restep-eco/EMI-Filter/EMI-Filter_Installed2.jpg

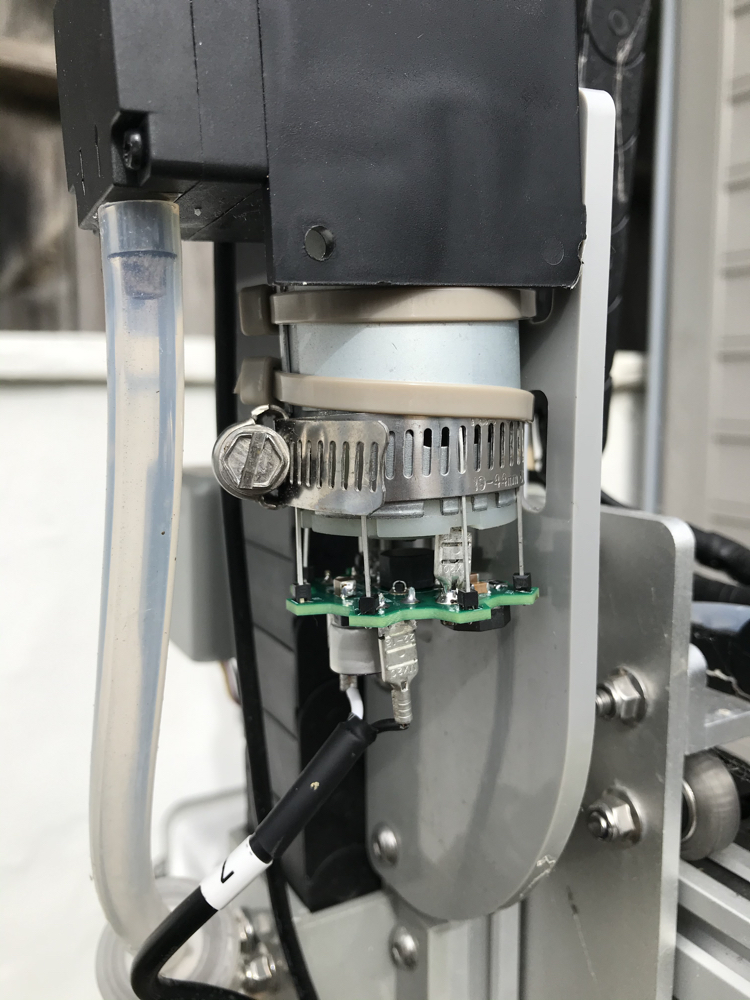
EMI-Filter_Installed2.jpg
