restep-eco/EMI-Filter/EMI-Filter-Installed3.jpg

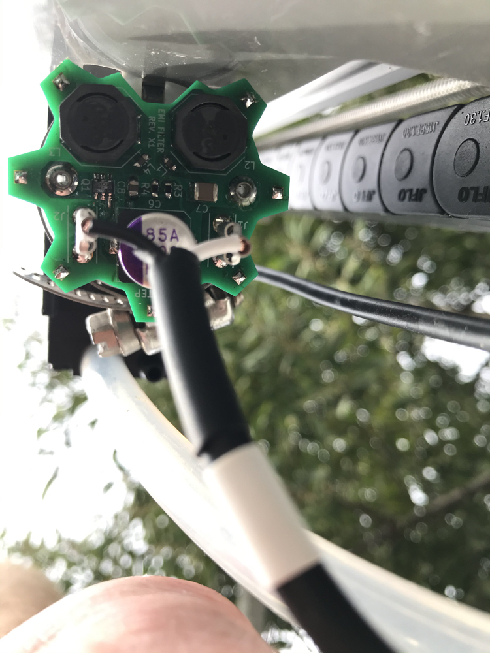
EMI-Filter-Installed3.jpg
