restep-eco/EMI-Filter/README.md

# EMI-Filter
RESTEP EMI FILTER

EMI Filter for the 24V FarmBot vacuum pump

Initial release (Rev.X1) 3/13/21: This revision is a prototype release. It is not fully tested or qualified.

Copyright RESTEP 2021.
This source describes Open Hardware and is licensed under the CERN-OHL-P v2
You may redistribute and modify this documentation and make products
using it under the terms of the CERN-OHL-P v2 (https:/cern.ch/cern-ohl).
This documentation is distributed WITHOUT ANY EXPRESS OR IMPLIED
WARRANTY, INCLUDING OF MERCHANTABILITY, SATISFACTORY QUALITY
AND FITNESS FOR A PARTICULAR PURPOSE. Please see the CERN-OHL-P v2
for applicable conditions.

Source files developed in KiCad 5.0.2.
Custom libraries and footprints are provided in the source files .zip.

All documentation is licensed under the Creative Commons Attribution 4.0 International License.

LTSpice circuit models (*.asc) are licensed under the MIT license.
