restep-eco/EMI-Filter/EMI-Filter-Back.jpg

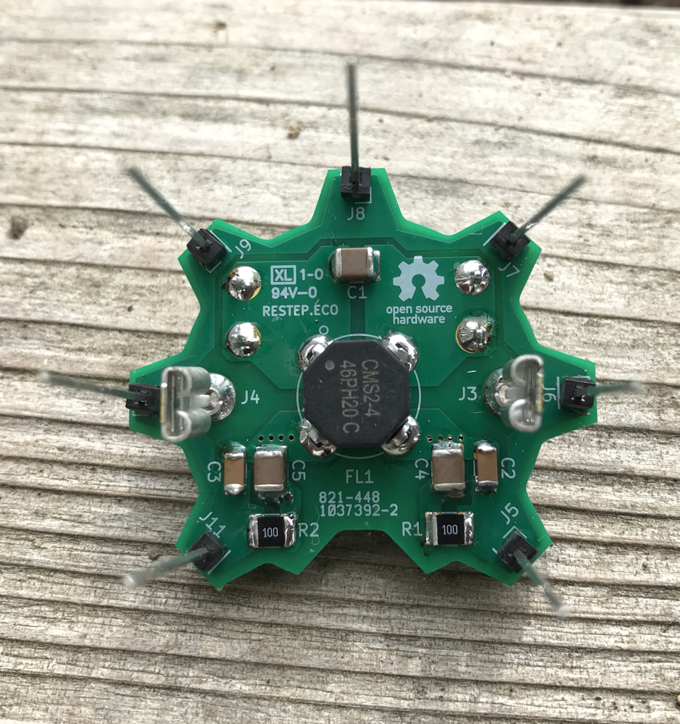
EMI-Filter-Back.jpg
