restep-eco/EMI-Filter/EMI-Filter-Front.jpg

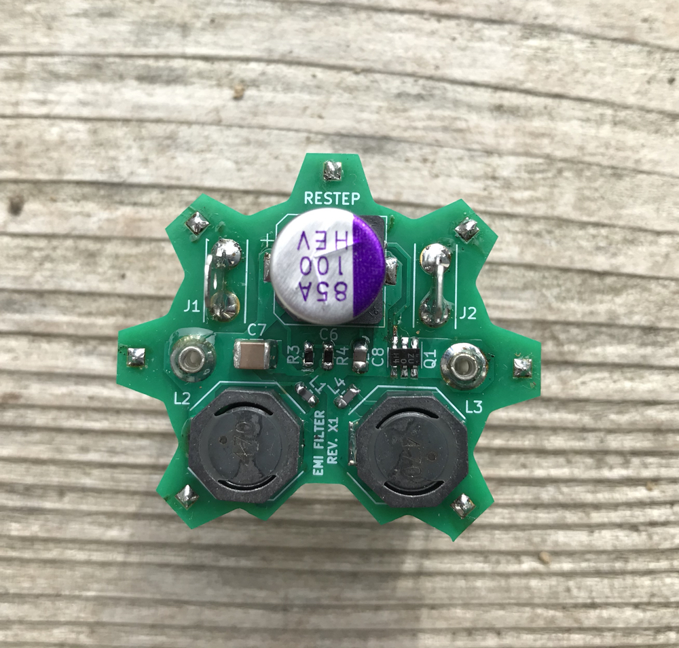
EMI-Filter-Front.jpg
