restep-eco/EMI-Filter/RESTEP EMI FILTER SCHEMATIC.pdf

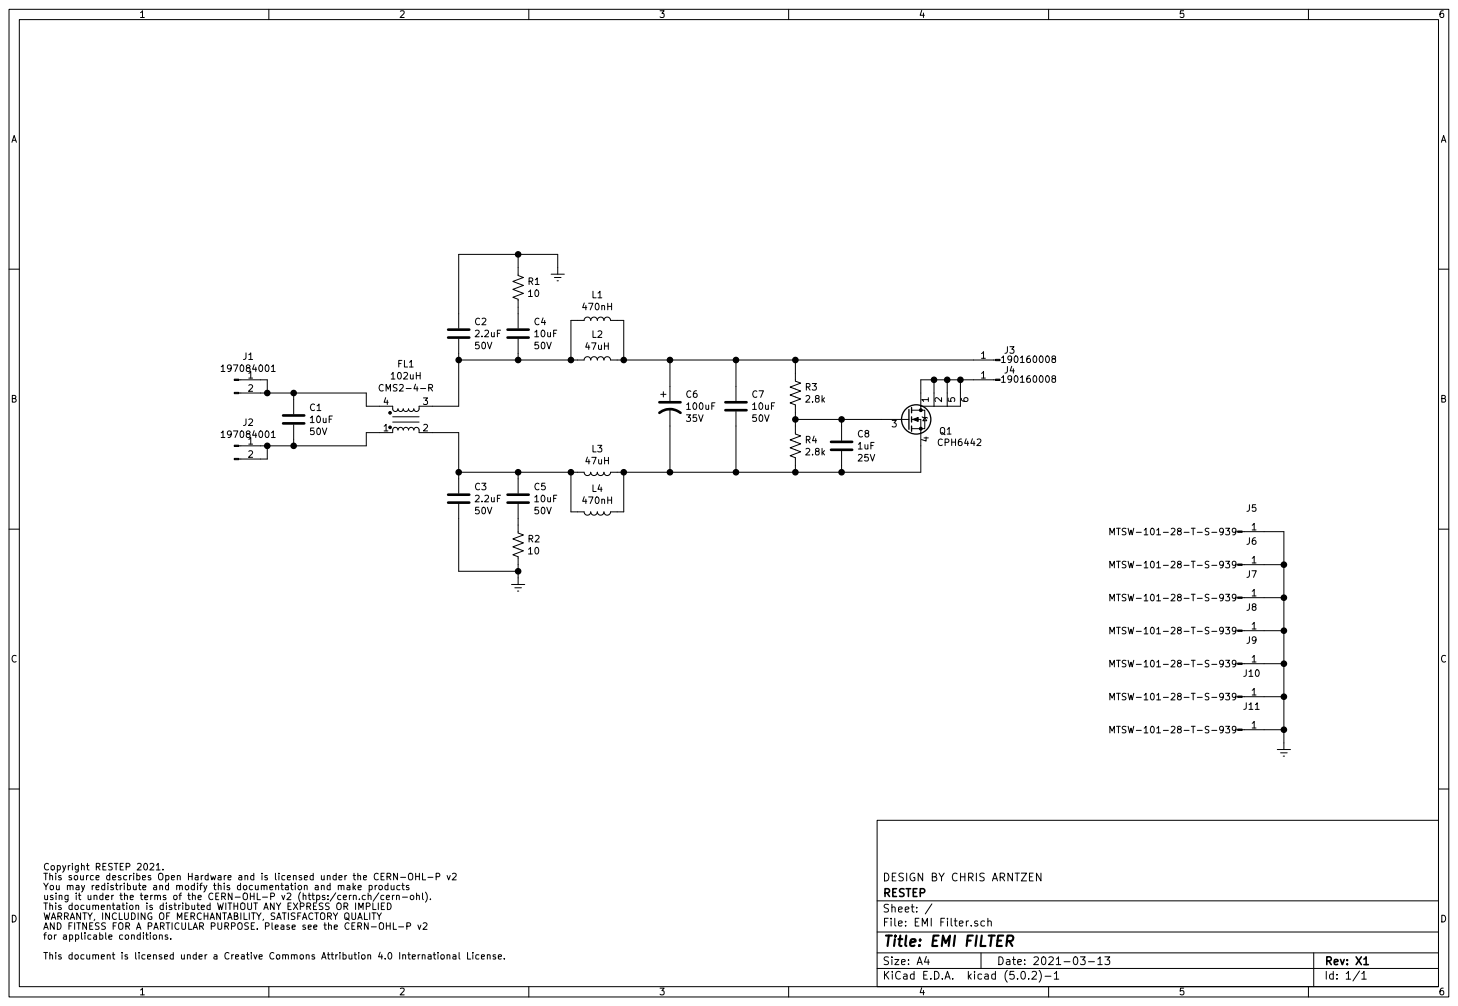
[picture p5: page 1]
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

File: EMI Filter.sch Sheet: / RESTEP DESIGN BY CHRIS ARNTZEN

AND FITNESS FOR A PARTICULAR PURPOSE. Please see the CERN-OHL-P v2
for applicable conditions. This document is licensed under a Creative Commons Attribution 4.0 International License.

Id: 1/1 Title: EMI FILTER
