restep-eco/EMI-Filter/RESTEP EMI FILTER PCB.pdf

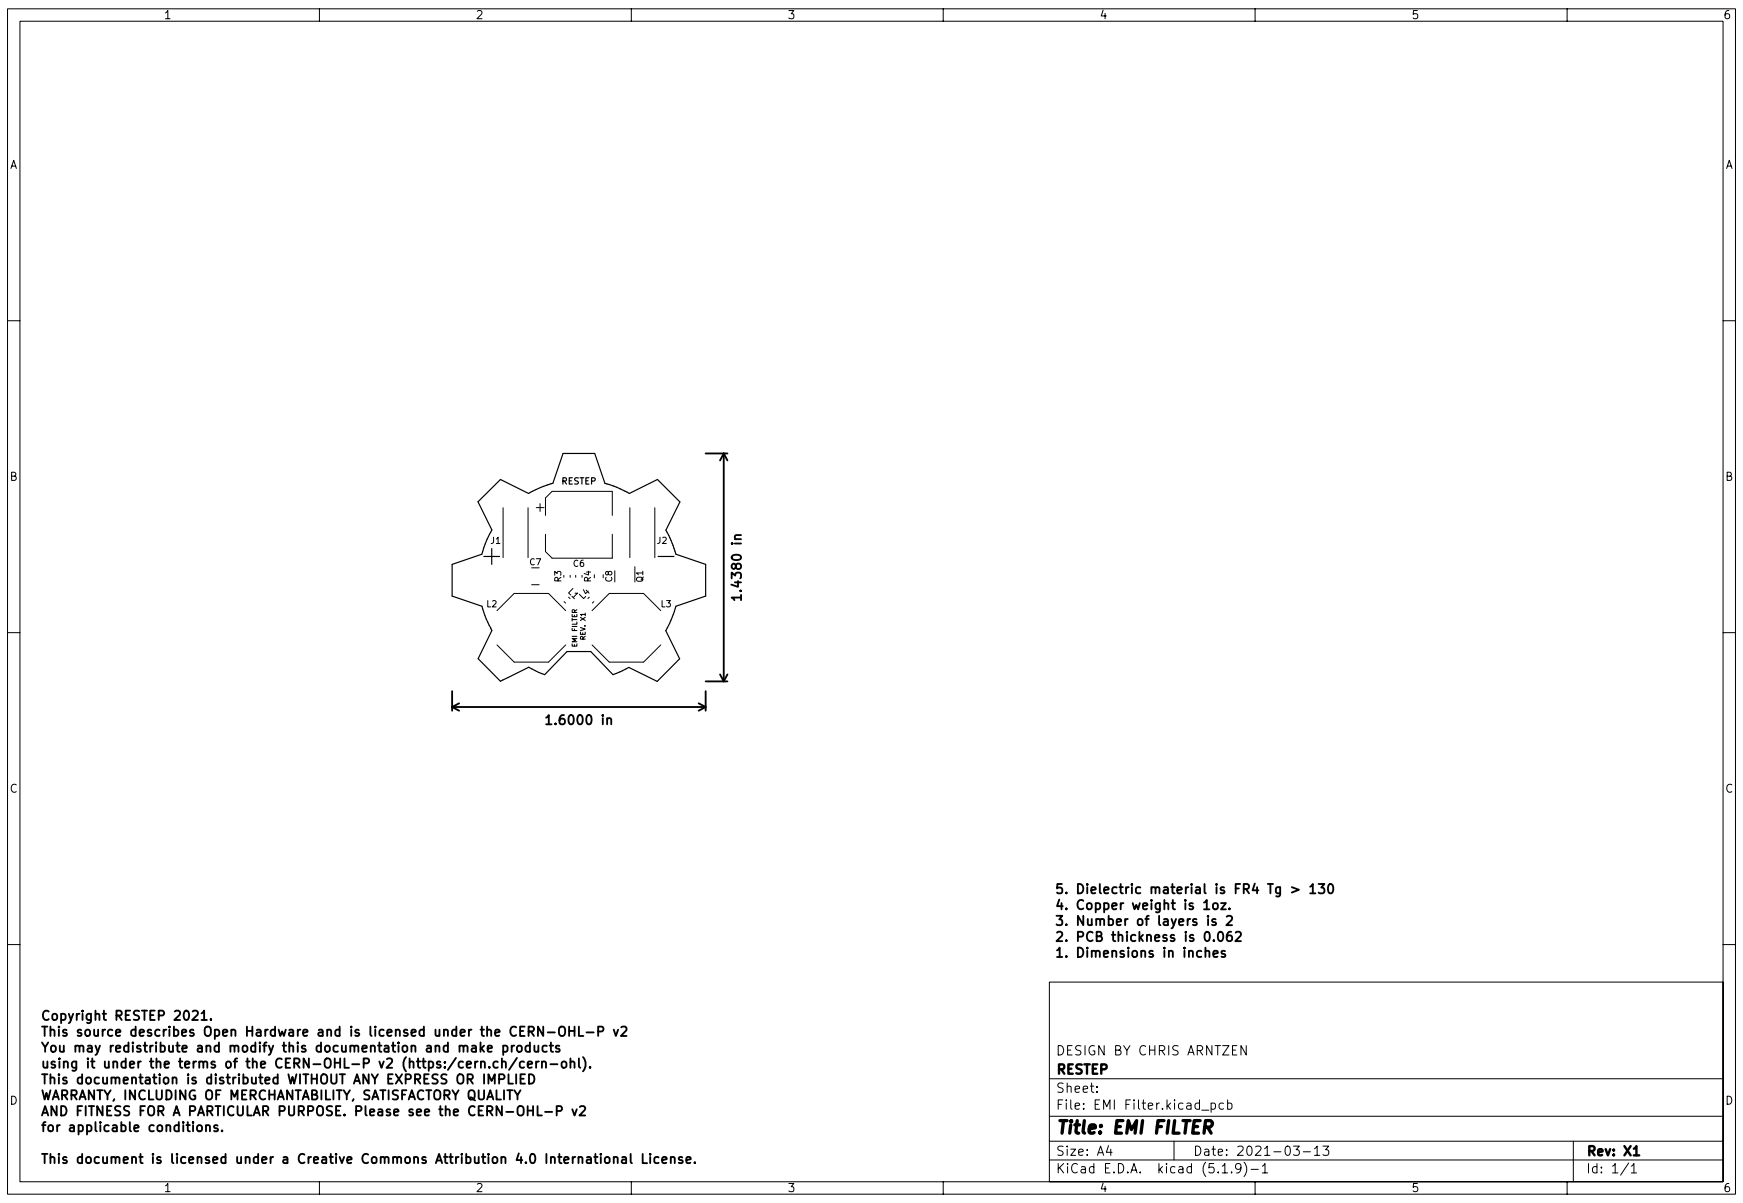
[picture p6: page 1]
