restep-eco/EMI-Filter/RESTEP EMI FILTER CM.asc

C3: cap; 8.1µ
C4: cap; 8.1µ
C5: cap; 1.2µ
C6: cap; 1.2µ
L1: ind; 47µ; Rser=121m
L2: ind; 470n; Rser=125m
L3: ind; 47µ; Rser=121m
L4: ind; 470n; Rser=125m
L5: ind2; 102µ; Rser=19m
L6: ind2; 102µ; Rser=19m
L7: ind; {Lk}
L8: ind; {Lk}
R1: res; 10
R2: res; 10
V1: voltage; ""; AC 1
Named nets: out, 0
K1 L5 L6 0.99
.ac dec 100 100 1meg
.param Lk 800n
RESTEP EMI FILTER X1 COMMON MODE MODEL
Copyright (c) 2021, RESTEP
 
Permission is hereby granted, free of charge, to any person obtaining a copy
of this software and associated documentation files (the "Software"), to deal
in the Software without restriction, including without limitation the rights
to use, copy, modify, merge, publish, distribute, sublicense, and/or sell
copies of the Software, and to permit persons to whom the Software is
furnished to do so, subject to the following conditions:
 
The above copyright notice and this permission notice shall be included in all
copies or substantial portions of the Software.
 
THE SOFTWARE IS PROVIDED "AS IS", WITHOUT WARRANTY OF ANY KIND, EXPRESS OR
IMPLIED, INCLUDING BUT NOT LIMITED TO THE WARRANTIES OF MERCHANTABILITY,
FITNESS FOR A PARTICULAR PURPOSE AND NONINFRINGEMENT. IN NO EVENT SHALL THE
AUTHORS OR COPYRIGHT HOLDERS BE LIABLE FOR ANY CLAIM, DAMAGES OR OTHER
LIABILITY, WHETHER IN AN ACTION OF CONTRACT, TORT OR OTHERWISE, ARISING FROM,
OUT OF OR IN CONNECTION WITH THE SOFTWARE OR THE USE OR OTHER DEALINGS IN THE
SOFTWARE.
