restep-eco/EMI-Filter/RESTEP EMI FILTER TRAN.asc

C1: cap; 100µ; Rser=28m
C2: cap; 10µ
C3: cap; 10µ
C4: cap; 10µ
C5: cap; 2.2µ
C6: cap; 2.2µ
C7: cap; 1µ
L1: ind; 47µ; Rser=121m
L2: ind; 470n; Rser=125m
L3: ind; 47µ; Rser=121m
L4: ind; 470n; Rser=125m
L5: ind2; 102µ; Rser=19m
L6: ind2; 102µ; Rser=19m
L7: ind; {Lk}
L8: ind; {Lk}
M1: nmos; IRF7201
R1: res; 10
R2: res; 10
R3: res; 2.8k
R4: res; 2.8k
R5: res; 48
V1: voltage; PULSE(0 24 .1m 100n 100n 1 2)
Named nets: out, 0, sns
K1 L5 L6 0.99
.param Lk 800n
RESTEP EMI FILTER X1 TRANSIENT MODEL
Copyright (c) 2021, RESTEP
 
Permission is hereby granted, free of charge, to any person obtaining a copy
of this software and associated documentation files (the "Software"), to deal
in the Software without restriction, including without limitation the rights
to use, copy, modify, merge, publish, distribute, sublicense, and/or sell
copies of the Software, and to permit persons to whom the Software is
furnished to do so, subject to the following conditions:
 
The above copyright notice and this permission notice shall be included in all
copies or substantial portions of the Software.
 
THE SOFTWARE IS PROVIDED "AS IS", WITHOUT WARRANTY OF ANY KIND, EXPRESS OR
IMPLIED, INCLUDING BUT NOT LIMITED TO THE WARRANTIES OF MERCHANTABILITY,
FITNESS FOR A PARTICULAR PURPOSE AND NONINFRINGEMENT. IN NO EVENT SHALL THE
AUTHORS OR COPYRIGHT HOLDERS BE LIABLE FOR ANY CLAIM, DAMAGES OR OTHER
LIABILITY, WHETHER IN AN ACTION OF CONTRACT, TORT OR OTHERWISE, ARISING FROM,
OUT OF OR IN CONNECTION WITH THE SOFTWARE OR THE USE OR OTHER DEALINGS IN THE
SOFTWARE.
.tran 10m
