restep-eco/EMI-Filter/EMI-Filter-Installed1.jpg

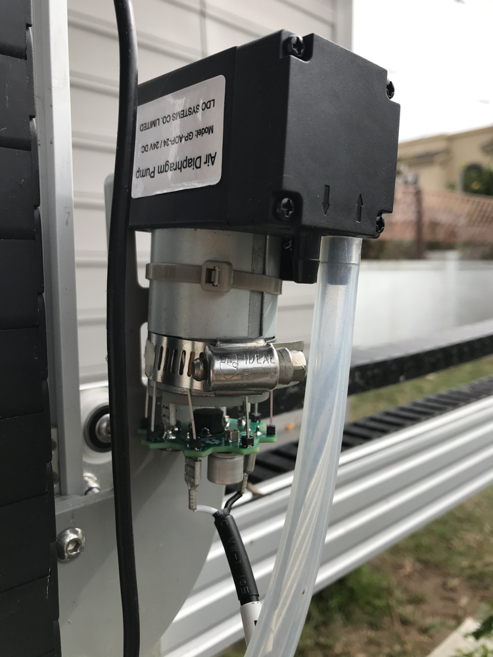
EMI-Filter-Installed1.jpg
