restep-eco/EMI-Filter/(commit log)

2021-03-09 Added photos of EMI Filter
    Rev. X1 EMI Filter for Restep vacuum pump
2021-03-09 Added EMI Filter Bill of Materials
    [EMI_Filter_BOM.xlsx]
2021-03-10 Update EMI_Filter_BOM.xlsx
    Reformatted and added to BOM
    [EMI_Filter_BOM.xlsx]
2021-03-14 Added source files
    Source files (KiCad, Gerbers, Excel BOM, CHANGES.txt) added in .zip file. Deleted Excel BOM from main directory.
    [EMI_Filter_BOM.xlsx]
2021-03-25 Added BOM
2021-03-25 Update RESTEP EMI FILTER MANUAL.pdf
2021-03-25 Update RESTEP EMI FILTER BOM.pdf
2021-03-26 Update RESTEP EMI FILTER SCHEMATIC.pdf
2021-03-26 Update RESTEP EMI FILTER PCB.pdf
2021-03-26 Update RESTEP EMI FILTER SOURCE FILES.zip
2021-03-26 Added KiCad note.
2021-03-26 Added note that rev X1 is a prototype.
2021-03-26 Noted KiCad libraries and footprints.
2021-07-01 Update RESTEP EMI FILTER MANUAL.pdf
    Added Absolute Maximum Ratings disclaimer and Minimum Operating Voltage
